ElectronicCats/HunterCatNFC/Hardware/HunterCat-NFC/Ensamblaje14.SLDASM

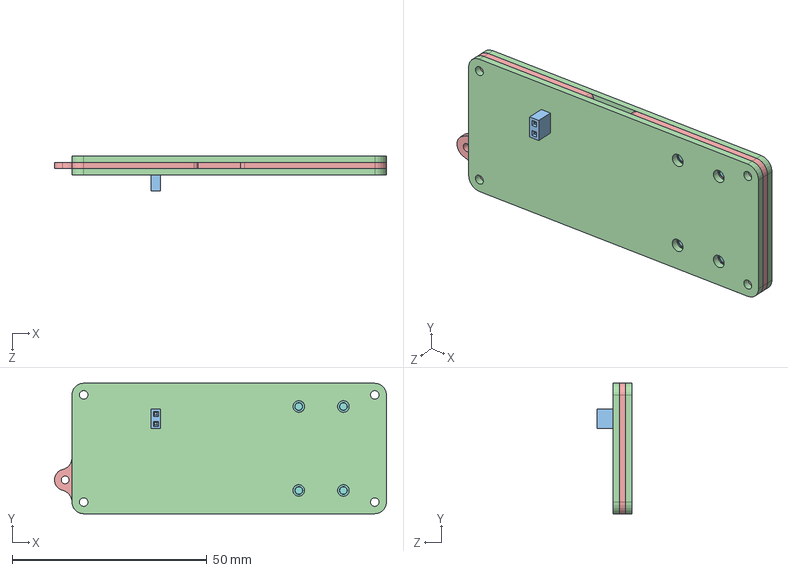
[picture p1: CAD file, 2020-12-15]
Hardware/HunterCat-NFC/Ensamblaje14.SLDASM
85.2 x 33.5 x 8.95 mm
SOLID.step
SOLID-0.step
SOLID-1.step x 21
SOLID-2.step x 2
SOLID-3.step x 20
SOLID-4.step x 4
SOLID-5.step
SOLID-6.step x 4
SOLID-7.step
SOLID-8.step x 2
SOLID-9.step
COMPOUND.step x 2
HunterCat-NFC
