ElectronicCats/HunterCatNFC/Hardware/Case/Case.step

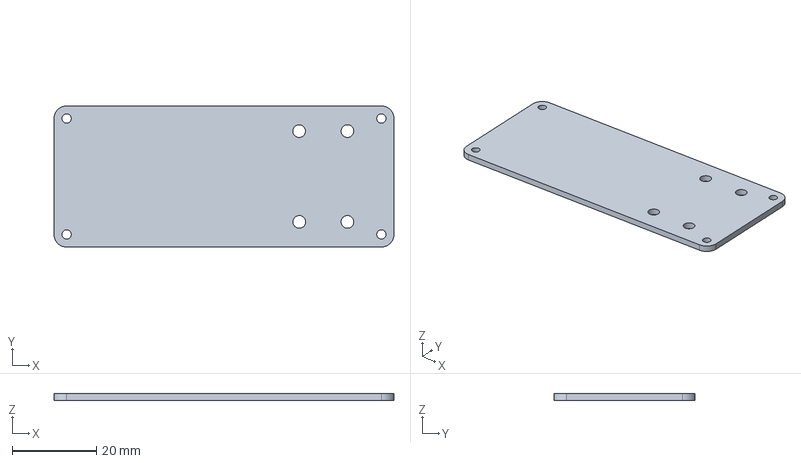
[picture p2: CAD file, 2020-12-15]
Hardware/Case/Case.step
80.7 x 33.5 x 1.60 mm
