ElectronicCats/HunterCatNFC/Hardware/HunterCat-NFC.SLDPRT

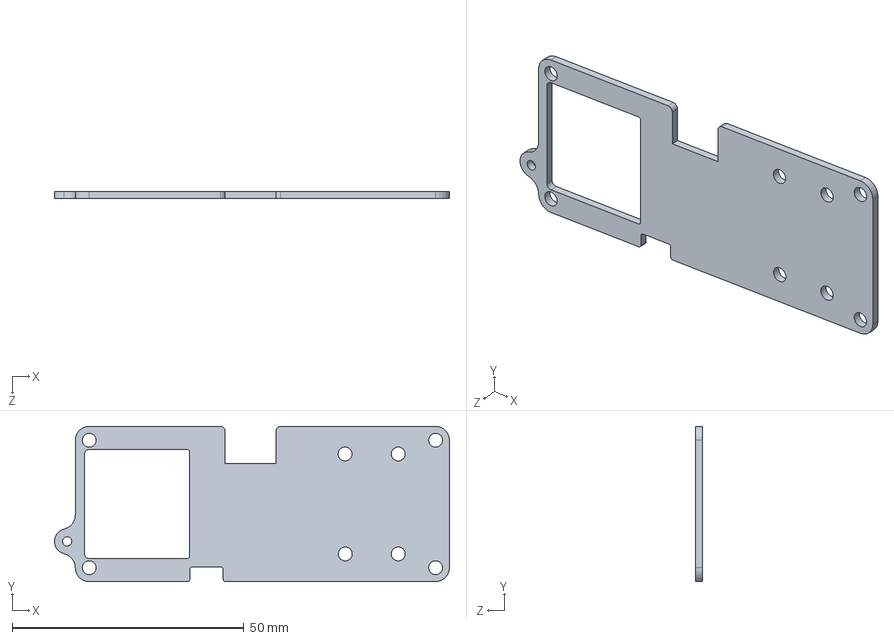
[picture p3: CAD file, 2021-02-05]
Hardware/HunterCat-NFC.SLDPRT
85.2 x 33.5 x 1.60 mm
