ElectronicCats/HunterCatNFC/(list of files, cad)

Other CAD files:
Hardware/Case/Case.SLDASM
Hardware/HunterCat-NFC.DXF
