ElectronicCats/HunterCatNFC/(threads)

Thread 3 (2021-08-28):

Can’t complete script

merdeux50, 2021-08-28:
I can’t seem to get it to extract track 2 data, I always get

Command: 0x80 0xA8 0x00 0x00 0x0C 0x83 0x0A 0xF6 0x20 0xC0 0x00 0x00 0x00 0x00 0x00 0x00 0x00 0x00
18:23:44.839 -> Card answer: 0x69 0x85
18:23:45.439 ->
18:23:45.439 -> Command: 0x00 0xB2 0x01 0x0C 0x00
18:23:45.439 -> Card answer: 0x6A 0x83
18:23:45.439 -> Could not find the track 2!

Closed 2022-10-12.

Thread 10 (2023-06-03):

ElectronicCats

Alfa16bravo, 2023-06-03:
hello, I just received my huntercat nfc v2 rp2040, I updated them with the u2f file, I put them in bootloader it is detected in mass storage I put the file, the board restarts (no blue light), when I unplug it and I switch it on, nothing happens, no lights come on, the board only lights up and stays on only if I plug it in and unplug it. in the arduino serial monitor it initializes well my is in huntercat nfc v1.3.

xpeqex, 2023-06-05:
Hi @Alfa16bravo

Thank you for reaching out to us via GitHub.

We have received your email regarding the same issue you are experiencing, and we would like to continue addressing this matter through email. Please expect a response to your email soon.

If you have any additional information or further questions, please feel free to include them in the email thread. We are here to help and ensure that your concerns are addressed.

Thank you once again for reaching out to us, and we look forward to assisting you further.
