ElectronicCats/HunterCatNFC/Hardware/HunterCat-NFC/HunterCat-NFC.pdf

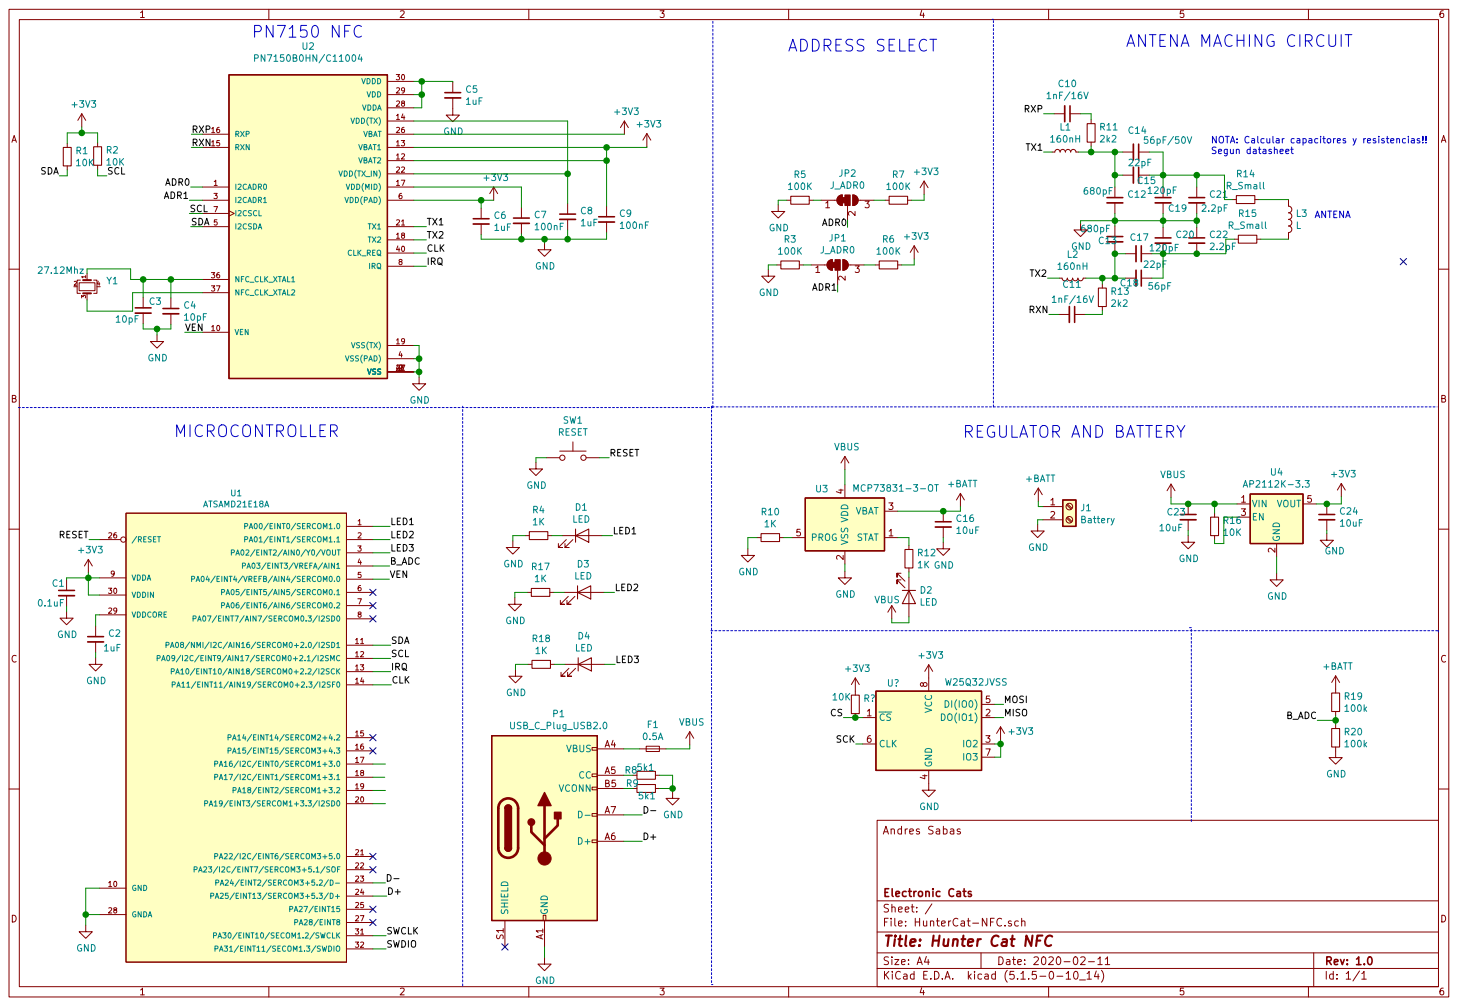
[picture p4: page 1]

NOTA: Calcular capacitores y resistencias!!
Segun datasheet

File: HunterCat-NFC.sch Sheet: / Electronic Cats Andres Sabas

Id: 1/1 Title: Hunter Cat NFC
