ElectronicCats/HunterCatNFC/Hardware/HunterCat-NFC/HunterCat-NFC.kicad_pcb

## KiCad design Hardware/HunterCat-NFC/HunterCat-NFC.kicad_pcb (2023-03-08)

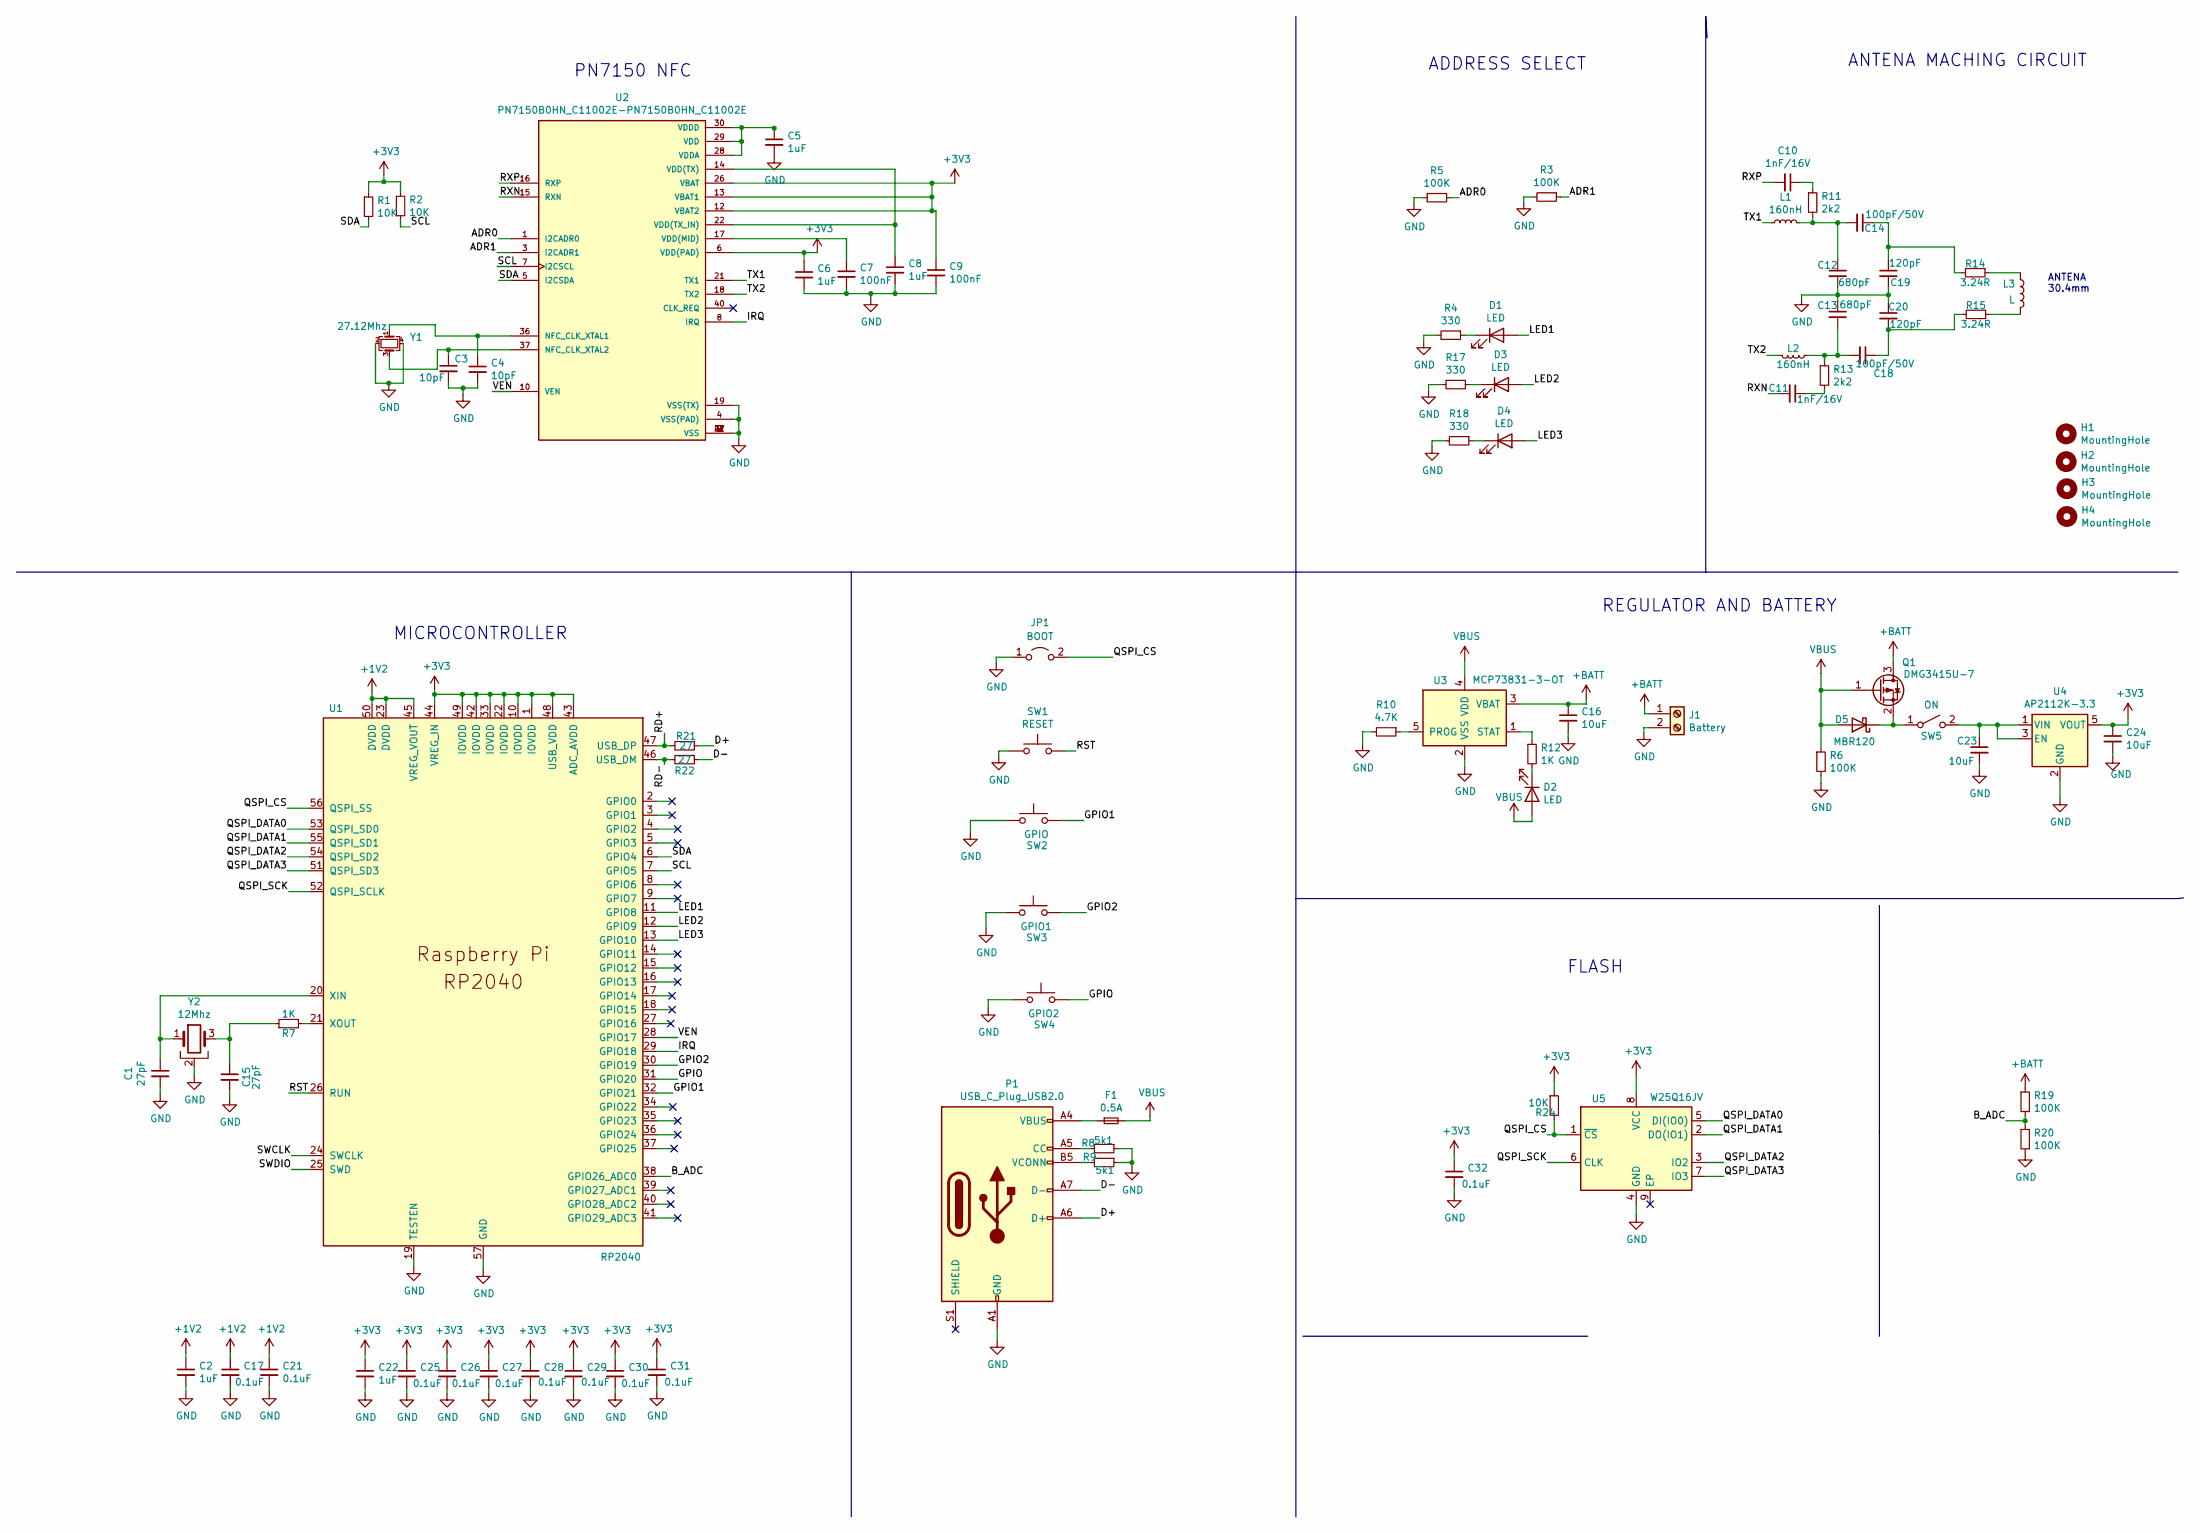
[picture p5: schematic HunterCat-NFC.kicad_sch, Hunter Cat NFC]

Parts:
C1, C15: 27pF; C_0603_1608Metric
C2, C22: 1uF; C_0603_1608Metric
C3, C4: 10pF; C_0603_1608Metric
C5, C6, C8: 1uF; C_0603_1608Metric; LCSC# C26413
C7, C9: 100nF; C_0603_1608Metric; LCSC# C387984
C10, C11: 1nF/16V; C_0603_1608Metric
C12, C13: 680pF; C_0603_1608Metric
C14, C18: 100pF/50V; C_0603_1608Metric
C16, C23, C24: 10uF; C_0603_1608Metric; LCSC# C326057
C17, C21, C25, C26, C27, C28, C29, C30, C31, C32: 0.1uF; C_0603_1608Metric
C19, C20: 120pF; C_0603_1608Metric
D1: LED; LED_0805_2012Metric_Pad1.15x1.40mm_HandSolder; LCSC# C130114
D2: LED; LED_0805_2012Metric_Pad1.15x1.40mm_HandSolder; LCSC# C205441
D3: LED; LED_0805_2012Metric_Pad1.15x1.40mm_HandSolder; LCSC# C205442
D4: LED; LED_0805_2012Metric_Pad1.15x1.40mm_HandSolder; LCSC# C84261
D5: MBR120; D_SOD-123F; LCSC# C723989
F1: 0.5A; Fuse_0603_1608Metric_Pad1.05x0.95mm_HandSolder
H1, H2, H3, H4: MountingHole; MountingHole_2.2mm_M2
J1: Battery; PinSocket_2x01_P2.54mm_Vertical_SMD
JP1: BOOT; SolderJumper-2_P1.3mm_Open_TrianglePad1.0x1.5mm
L1, L2: 160nH; L_0603_1608Metric_Pad1.05x0.95mm_HandSolder; LCSC# C434822
L3: L; NFC-antenna30.4x30.4mm
P1: USB_C_Plug_USB2.0; C393939; LCSC# C393939
Q1: DMG3415U-7; SOT-23; LCSC# C96616
R1, R2: 10K; R_0603_1608Metric; LCSC# C15401
R3, R5, R6, R19, R20: 100K; R_0603_1608Metric; LCSC# C15458
R4, R17, R18: 330; R_0603_1608Metric; LCSC# C517454
R7: 1K; R_0603_1608Metric
R8, R9: 5k1; R_0603_1608Metric; LCSC# C131715
R10: 4.7K; R_0603_1608Metric; LCSC# C116693
R11, R13: 2k2; R_0603_1608Metric; LCSC# C217937
R12: 1K; R_0603_1608Metric; LCSC# C517454
R14, R15: 3.24R; R_0603_1608Metric
R21, R22: 27; R_0603_1608Metric
R24: 10K; R_0603_1608Metric
SW1: RESET; KSC941JLFS; LCSC# C221771
SW2: GPIO; KSC941JLFS; LCSC# C221771
SW3: GPIO1; KSC941JLFS; LCSC# C221771
SW4: GPIO2; KSC941JLFS; LCSC# C221771
SW5: ON; Micro_interruptor_SPDT
U1: RP2040; RP2040-QFN-56
U2: PN7150B0HN_C11002E-PN7150B0HN_C11002E; QFN-40-1EP_6x6mm_P0.5mm_EP4.6x4.6mm
U3: MCP73831-3-OT; SOT-23-5
U4: AP2112K-3.3; SOT-23-5
U5: W25Q16JV; W25Q16JVUUIQ
Y1: 27.12Mhz; Crystal_SMD_2016-4Pin_2.0x1.6mm
Y2: 12Mhz; Crystal_SMD_2520-4Pin_2.5x2.0mm; LCSC# C709001

Connections:
+1V2: C2.1, C17.1, C21.1, U1.23 (DVDD), U1.45 (VREG_VOUT), U1.50 (DVDD)
+3V3: C6.1, C9.1, C22.1, C24.1, C25.1, C26.1, C27.1, C28.1, C29.1, C30.1, C31.1, C32.1, R1.1, R2.1, R24.1, U1.1 (IOVDD), U1.10 (IOVDD), U1.22 (IOVDD), U1.33 (IOVDD), U1.42 (IOVDD), U1.43 (ADC_AVDD), U1.44 (VREG_IN), U1.48 (USB_VDD), U1.49 (IOVDD), U2.6 (VDD(PAD)), U2.12 (VBAT2), U2.13 (VBAT1), U2.26 (VBAT), U4.5 (VOUT), U5.8 (VCC)
+BATT: C16.1, J1.1, Q1.3 (D), R19.1, U3.3 (VBAT)
/ADR0: R5.1, U2.1 (I2CADR0)
/ADR1: R3.1, U2.3 (I2CADR1)
/B_ADC: R19.2, R20.1, U1.38 (GPIO26_ADC0)
/D+: P1.A6 (D+), R21.1
/D-: P1.A7 (D-), R22.1
/GPIO: SW4.2, U1.31 (GPIO20)
/GPIO1: SW2.2, U1.32 (GPIO21)
/GPIO2: SW3.2, U1.30 (GPIO19)
/IRQ: U1.29 (GPIO18), U2.8 (IRQ)
/LED1: D1.2 (A), U1.11 (GPIO8)
/LED2: D3.2 (A), U1.12 (GPIO9)
/LED3: D4.2 (A), U1.13 (GPIO10)
/QSPI_CS: JP1.2 (B), R24.2, U1.56 (QSPI_SS), U5.1 (~CS)
/QSPI_DATA0: U1.53 (QSPI_SD0), U5.5 (DI(IO0))
/QSPI_DATA1: U1.55 (QSPI_SD1), U5.2 (DO(IO1))
/QSPI_DATA2: U1.54 (QSPI_SD2), U5.3 (IO2)
/QSPI_DATA3: U1.51 (QSPI_SD3), U5.7 (IO3)
/QSPI_SCK: U1.52 (QSPI_SCLK), U5.6 (CLK)
/RD+: R21.2, U1.47 (USB_DP)
/RD-: R22.2, U1.46 (USB_DM)
/RST: SW1.2, U1.26 (RUN)
/RXN: C11.2, U2.15 (RXN)
/RXP: C10.2, U2.16 (RXP)
/SCL: R2.2, U1.7 (GPIO5), U2.7 (I2CSCL)
/SDA: R1.2, U1.6 (GPIO4), U2.5 (I2CSDA)
/SWCLK: U1.24 (SWCLK)
/SWDIO: U1.25 (SWD)
/TX1: L1.1, U2.21 (TX1)
/TX2: L2.2, U2.18 (TX2)
/VEN: U1.28 (GPIO17), U2.10 (VEN)
GND: C1.2, C2.2, C3.2, C4.2, C5.2, C6.2, C7.2, C8.2, C9.2, C12.2, C13.1, C15.2, C16.2, C17.2, C19.2, C20.1, C21.2, C22.2, C23.2, C24.2, C25.2, C26.2, C27.2, C28.2, C29.2, C30.2, C31.2, C32.2, J1.2, JP1.1 (A), P1.A1 (GND), P1.A12 (GND), P1.B1 (GND), P1.B12 (GND), R3.2, R4.2, R5.2, R6.2, R8.1, R9.1, R10.2, R17.2, R18.2, R20.2, SW1.1, SW2.1, SW3.1, SW4.1, U1.19 (TESTEN), U1.57 (GND), U2.2 (VSS), U2.4 (VSS(PAD)), U2.9 (VSS), U2.19 (VSS(TX)), U2.27 (VSS), U2.41 (VSS), U3.2 (VSS), U4.2 (GND), U5.4 (GND), Y1.2, Y1.4, Y2.2
unnamed: C1.1, U1.20 (XIN), Y2.1
unnamed: C3.1, U2.37 (NFC_CLK_XTAL2), Y1.3
unnamed: C4.1, U2.36 (NFC_CLK_XTAL1), Y1.1
unnamed: C5.1, U2.28 (VDDA), U2.29 (VDD), U2.30 (VDDD)
unnamed: C7.1, U2.17 (VDD(MID))
unnamed: C8.1, U2.14 (VDD(TX)), U2.22 (VDD(TX_IN))
unnamed: C10.1, R11.1
unnamed: C11.1, R13.2
unnamed: C12.1, C14.2, L1.2, R11.2
unnamed: C13.2, C18.2, L2.1, R13.1
unnamed: C14.1, C19.1, R14.2
unnamed: C15.1, R7.1, Y2.3
unnamed: C18.1, C20.2, R15.2
unnamed: C23.1, SW5.2 (B), U4.1 (VIN), U4.3 (EN)
unnamed: D1.1 (K), R4.1
unnamed: D2.1 (K), R12.2
unnamed: D3.1 (K), R17.1
unnamed: D4.1 (K), R18.1
unnamed: D5.1 (K), Q1.2 (S), SW5.1 (A)
unnamed: F1.1, P1.A4 (VBUS), P1.A9 (VBUS), P1.B4 (VBUS), P1.B9 (VBUS)
unnamed: L3.1, R14.1
unnamed: L3.2, R15.1
unnamed: P1.A5 (CC), R8.2
unnamed: P1.B5 (VCONN), R9.2
unnamed: R7.2, U1.21 (XOUT)
unnamed: R10.1, U3.5 (PROG)
unnamed: R12.1, U3.1 (STAT)
VBUS: D2.2 (A), D5.2 (A), F1.2, Q1.1 (G), R6.1, U3.4 (VDD)

Notes on the sheet:
ADDRESS SELECT
PN7150 NFC
ANTENA MACHING CIRCUIT
REGULATOR AND BATTERY
MICROCONTROLLER
FLASH
ANTENA 30.4mm

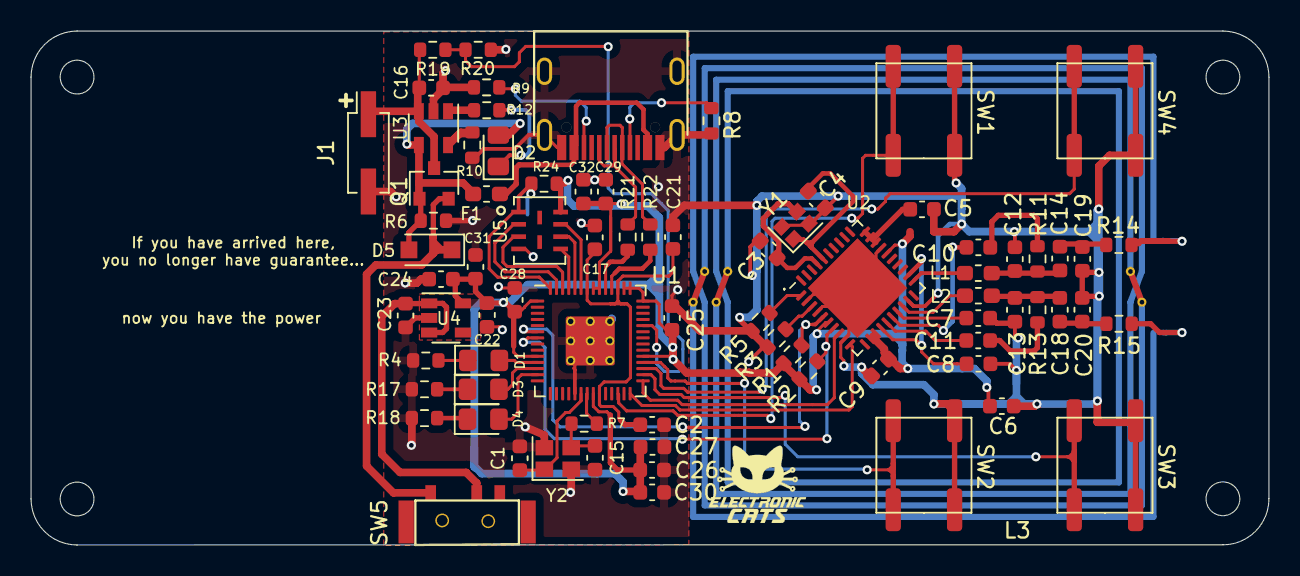
[picture p6: board HunterCat-NFC.kicad_pcb from above]

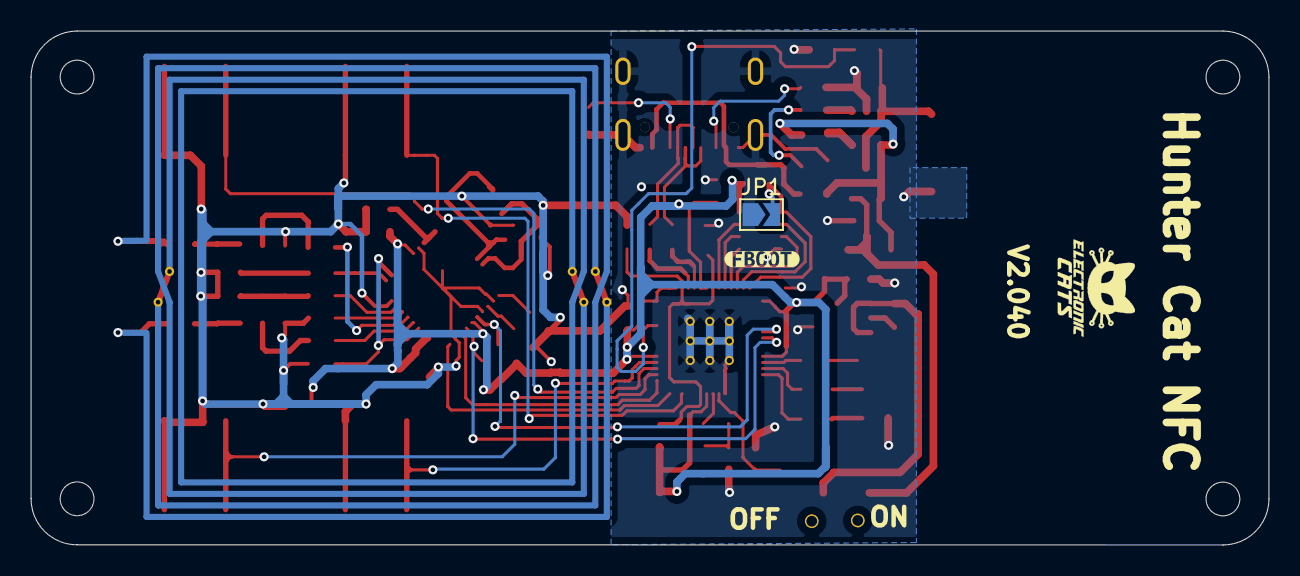
[picture p7: board HunterCat-NFC.kicad_pcb from below]

Board: 2 copper layers, 80.7 x 33.5 mm, 84 parts (3 on the bottom side), 60 nets.

Other parts of the board:
kibuzzard-62BD092C: G***; kibuzzard-62BD092C
