ElectronicCats/HunterCatNFC/(commit log)

2020-02-11 PN7150 basic schematic
    [HunterCat-NFC.kicad_pcb, HunterCat-NFC.sch]
2020-02-11 add samd21e
    [HunterCat-NFC.sch]
2020-02-12 alpha version
    [HunterCat-NFC.sch]
2020-02-12 add addres select I2C
    [HunterCat-NFC.sch]
2020-02-12 update components
    [HunterCat-NFC.sch]
2020-03-09 add SPI flash and ADC Battery
    [HunterCat-NFC.sch]
2020-03-10 add SPI pins
    [HunterCat-NFC.sch]
2020-03-25 add antennas footprints
2020-03-26 Update libraries, add antenna 30x30mm
    [HunterCat-NFC.kicad_pcb, HunterCat-NFC.sch]
2020-03-26 update sheet
    [HunterCat-NFC.kicad_pcb, HunterCat-NFC.sch]
2020-03-27 new size for hunter cat family
    [HunterCat-NFC.kicad_pcb]
2020-03-29 fix GND crystal
    [HunterCat-NFC.sch]
2020-04-03 add connector test breakout
    [HunterCat-NFC.sch]
2020-04-08 update pcb
    [HunterCat-NFC.kicad_pcb, HunterCat-NFC.sch]
2020-04-08 add footprint crystal and battery connector
    [HunterCat-NFC.kicad_pcb, HunterCat-NFC.sch]
2020-04-08 fix routeo
    [HunterCat-NFC.kicad_pcb]
2020-04-09 add c25
    [HunterCat-NFC.kicad_pcb, HunterCat-NFC.sch]
2020-04-09 add logos
    [HunterCat-NFC.kicad_pcb]
2020-04-10 value c25
    [HunterCat-NFC.kicad_pcb, HunterCat-NFC.sch]
2020-04-10 Fix routes and component placement, ground plane not on antenna
    [HunterCat-NFC.kicad_pcb]
2020-04-10 fix label
    [HunterCat-NFC.kicad_pcb]
2020-04-10 Update SPI Flash and Gerbers settings
    [HunterCat-NFC.kicad_pcb, HunterCat-NFC.sch]
2020-04-10 Add beta testing logo
    [HunterCat-NFC.kicad_pcb]
2020-04-21 change manf#
    [HunterCat-NFC.sch]
2020-07-27 Change sch
    [HunterCat-NFC.sch]
2020-07-29 Fix Batt source
    [HunterCat-NFC.sch]
2020-07-29 labels size
    [HunterCat-NFC.kicad_pcb]
2020-08-02 Last change
    [HunterCat-NFC.kicad_pcb, HunterCat-NFC.sch]
2020-08-06 select case
    [Case.kicad_pcb]
2020-08-07 Add screws
    [HunterCat-NFC.kicad_pcb]
2020-08-07 New Case
    [Case.kicad_pcb, HunterCat-NFC.kicad_pcb]
2020-08-17 modify Rf frontend
    [HunterCat-NFC.kicad_pcb, HunterCat-NFC.sch]
2020-08-20 Add button
    [Case.kicad_pcb, HunterCat-NFC.kicad_pcb, HunterCat-NFC.sch]
2020-08-21 Last Revision
    [HunterCat-NFC.kicad_pcb]
2020-08-25 new size
    [HunterCat-NFC.kicad_pcb]
2020-08-28 Change ant
    [HunterCat-NFC.kicad_pcb]
2020-08-28 Change Position
    [HunterCat-NFC.kicad_pcb]
2020-08-31 update to 1.0v
    [HunterCat-NFC.kicad_pcb, HunterCat-NFC.sch]
2020-08-31 new labels
    [HunterCat-NFC.kicad_pcb]
2020-09-01 Mounting Hole
    [HunterCat-NFC.kicad_pcb]
2020-09-01 modify coil holes
    [HunterCat-NFC.kicad_pcb]
2020-09-29 Update labels VEN and IRQ
    [HunterCat-NFC.sch]
2020-10-06 fix mosfet and battery voltage
    [HunterCat-NFC.sch]
2020-10-06 update v1.1 2 layes
    [HunterCat-NFC.kicad_pcb, HunterCat-NFC.sch]
2020-10-06 fiz silk and layout
    [HunterCat-NFC.kicad_pcb]
2020-10-06 update traces
    [HunterCat-NFC.kicad_pcb]
2020-10-06 minor silkscreen changes
    [HunterCat-NFC.kicad_pcb]
2020-10-19 add logos and mounitng holes again
    [HunterCat-NFC.kicad_pcb, HunterCat-NFC.sch]
2020-10-19 Accommodated screw holes
    [HunterCat-NFC.kicad_pcb]
2020-10-20 add switch on off
    [HunterCat-NFC.kicad_pcb]
2020-10-22 Moved the battery footprint
    [HunterCat-NFC.kicad_pcb]
2020-10-27 Moved footprints
    [Case.kicad_pcb, HunterCat-NFC.kicad_pcb]
2020-10-27 Case holes placement
    [Case.kicad_pcb]
2020-11-05 update case
2020-11-05 Update setting pcb
2020-11-10 update BOM
    [HunterCat-NFC.sch]
2020-11-12 update v1.2 footprint
    [HunterCat-NFC.kicad_pcb, HunterCat-NFC.sch]
2020-11-13 update graphic
    [Case.kicad_pcb]
2020-11-13 Fixed Case
    [Case.kicad_pcb, Case.step, HunterCat-NFC.SLDPRT, HunterCat-NFC.kicad_pcb]
2020-11-13 Fixed Led window
    [Case.kicad_pcb]
2020-11-26 fix B.Silks
    [Case.kicad_pcb]
2020-12-01 fix label on/off
    [HunterCat-NFC.kicad_pcb]
2020-12-15 The PCB became more symmetric
    [HunterCat-NFC.DXF, HunterCat-NFC.SLDPRT, HunterCat-NFC.kicad_pcb]
2020-12-15 moved some labels
    [HunterCat-NFC.kicad_pcb]
2020-12-15 Symmetric design (case and acrylic)
    [Case.SLDASM, Case.kicad_pcb, Case.step, Ensamblaje14.SLDASM, HunterCat-NFC.DXF, HunterCat-NFC.SLDPRT, HunterCat-NFC.kicad_pcb]
2020-12-30 rename folder hardware
    [Case.SLDASM, Case.kicad_pcb, Case.sch, Case.step, Ensamblaje14.SLDASM, HunterCat-NFC.kicad_pcb, HunterCat-NFC.sch]
2020-12-30 move file
    [HunterCat-NFC.SLDPRT]
2021-01-12 Added LED and Buttons for define
2021-01-21 update flash memmory
    [HunterCat-NFC.kicad_pcb, HunterCat-NFC.sch]
2021-02-05 Added .dxf archive
    [HunterCat-NFC.DXF, HunterCat-NFC.SLDPRT]
2021-03-24 add leds error
2021-03-24 Add RGB leds control and low Battery
2021-03-24 update F.Cu case
    [Case.kicad_pcb]
2021-03-30 add battery notification
2021-04-15 add LED error configuration and init
    [hunterCatNFC_AllOne.ino]
2022-06-02 update labels for v1.4
    [HunterCat-NFC.kicad_pcb]
2022-06-23 Replace RP2040 pins labels
    [HunterCat-NFC.kicad_sch]
2022-06-23 Assigned footprints
    [HunterCat-NFC.kicad_sch]
2022-06-24 Replace RP2040 crystal footprint
    [HunterCat-NFC.kicad_sch]
2022-06-28 Starting the change of PCB design
    [HunterCat-NFC.kicad_pcb]
2022-06-28 change button for jumper force boot
    [HunterCat-NFC.kicad_sch]
2022-06-30 update layout to 3.0v
    [HunterCat-NFC.kicad_pcb, HunterCat-NFC.kicad_sch]
2022-06-30 update labels v2.040
    version for RP2040
    [HunterCat-NFC.kicad_pcb]
2022-07-16 add notconnect
    [HunterCat-NFC.kicad_sch]
2022-07-29 change resistor charger
    [HunterCat-NFC.kicad_sch]
2022-11-23 Changed charge resistance to 4.7K and updated BOM
    [HunterCat-NFC.csv, HunterCat-NFC.kicad_sch]
2023-03-08 Changed Button
    [HunterCat-NFC.kicad_pcb, HunterCat-NFC.kicad_sch]
2023-09-16 add button donation
2023-12-22 change store button
